kilian-salome/Robot-reveil/README.md

# Robot-reveil
Robot reveil qui s'enfuit
