kilian-salome/Robot-reveil/Rapports seances/Images-import/Read-Me

On crée un fichier avec toutes les images qu'on a besoin d'importer dans nos compte-rendus
