kilian-salome/Robot-reveil/Cahiers_des_charges.md

<h1>Cahiers des charges du projet</h1>
<p>
  <em>Concernant l'idée de ce projet, disons que <a href="https://www.youtube.com/watch?v=izWCU4Y61o4">cette vidéo</a> a été la principale source d'inspiration et que cette idée a réveillée en nous la determination nécessaire à ce projet... </em>
  <h2>Robot-réveil: quésako?</h2>
  <ul>
  <li>Ce projet consiste à créer un robot réveil qui s'enfuit lorsqu'il sonne. Il faut ainsi se lever pour l'arrêter. Le robot peut tomber des meubles. Il peut aussi se prendre des murs. Lorsqu'il s'en prend, il recule un peu puis tourne pour changer de direction.
  
 <li>Le réveil sera programmable depuis un téléphone portable. Il aura donc plusieurs fonctionnalités : alarme et connexion bluetooth. Il pourra aussi donner l'heure lorsqu'on appuie sur un bouton. Sinon, il se mettra en veille.
  
  <li>La voiture pourra tourner, avancer, reculer. Elle sera constituée de deux roues. Il faudra donc mettre un contre-poids pour qu'elle ne tourne pas, que ce soit uniquement les roues qui tournent. 
 
</ul>
<h2>Etapes à suivre:</h2>
<ul>
  <li>Premièrement, il faut faire le réveil. D'abord, réussir à afficher l'heure avec arduino, puis utiliser le module bluetooth pour afficher l'heure depuis notre téléphone portable. Il faut aussi utiliser un buzzer pour pouvoir le faire sonner et s'arrêter lorqu'on appuie.
  <li>Ensuite, il faut faire la voiture. Concernant la structure, on peut soit la dessiner sur un logiciel puis l'imprimer en 3D, soit la constuire nous-même. Pour la faire fonctionner, nous allons utiliser des petits moteurs (comme en TD). Pour relier les roues au moteur, il nous faut des suspensions. 
  <li>Finalement, il faut assembler réveil avec la voiture. Nous allons programmer la voiture de sorte à ce qu'elle se mette en marche lorsque le réveil sonne. Le trajet de la voiture est aléatoire. La voiture s'arrête en même tant que l'alarme.
</ul>
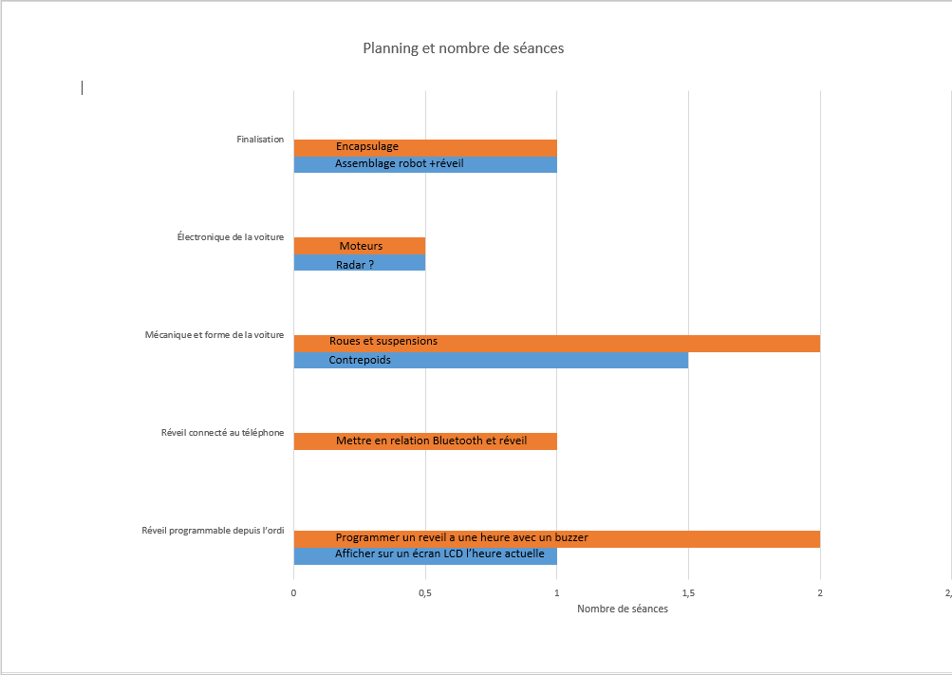
[picture p31: planning n1.png]
voir planning

<em>(Ceci est le planning numéro 1, celui-ci va surement devoir etre bousculé donc on rajoutera les planning au fur et à mesures des séances)</em>

<h2>Problèmes potentiels:</h2>
  <ul> 
  <li>Avec le réveil, on peut avoir des problèmes concernant le module nous permettant d'avoir l'heure. En effet, il n'aura peut être pas assez de pile pour rester allumé toute la nuit. 
  <li>On peut aussi rencontrer des problèmes avec la voiture. D'abord, il ne faut pas qu'elle soit trop fragile puisqu'elle peut tomber des meubles. Ensuite, il faut réussir à trouver un bon moyen de faire un contre poids pour que le système reste toujours dans le même sens.
</ul>
</p>
