kilian-salome/Robot-reveil/planning final.png

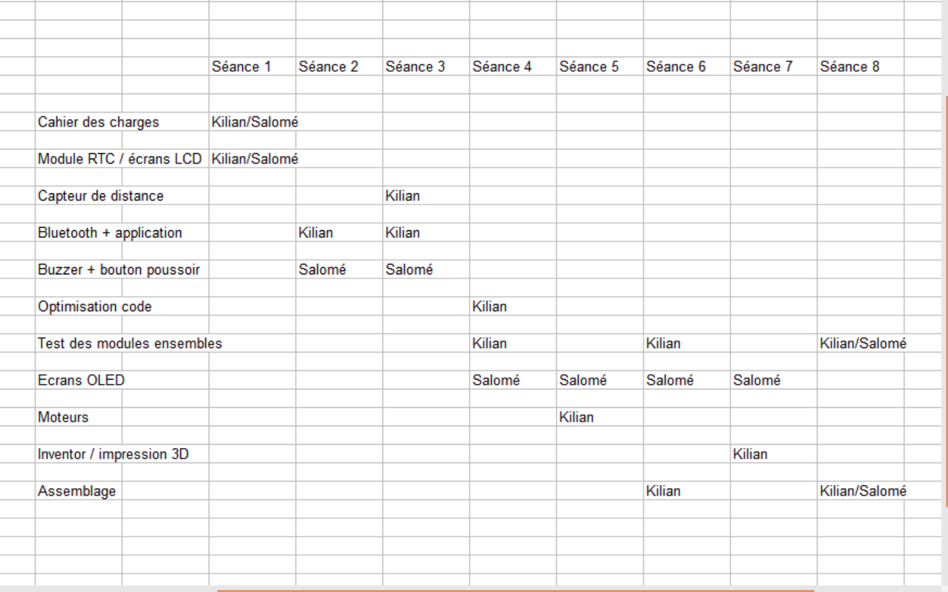
planning final.png
