kilian-salome/Robot-reveil/planning initial.png

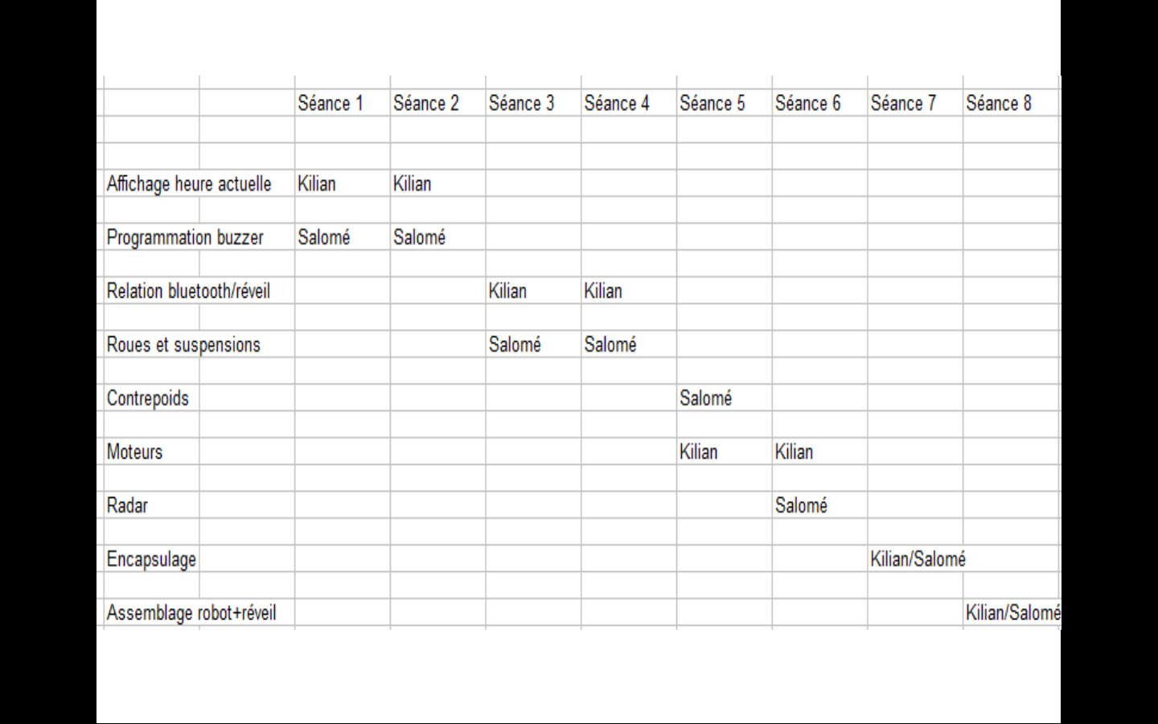
planning initial.png
