kilian-salome/Robot-reveil/Rapports seances/Images-import/presentation projet.jpg

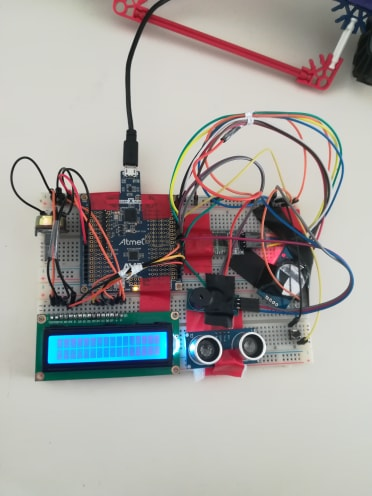
Rapports seances/Images-import/presentation projet.jpg
