kilian-salome/Robot-reveil/Rapport +codes plus diagrammes finals/ecran_couleur.ino

#include <SPI.h>
#include <Wire.h>
#include <Adafruit_GFX.h>
#include <Adafruit_SSD1351.h>

#define OLED_DC    8
#define OLED_CS1  10
#define OLED_CS2  7
#define OLED_RESET1 9
#define OLED_RESET2 6

Adafruit_SSD1351 display1 = Adafruit_SSD1351(OLED_CS1, OLED_DC, OLED_RESET1);
Adafruit_SSD1351 display2 = Adafruit_SSD1351(OLED_CS2, OLED_DC, OLED_RESET2);

// Color definitions
#define  BLACK           0x0000
#define BLUE            0x001F
#define RED             0xF800
#define GREEN           0x07E0
#define CYAN            0x07FF
#define MAGENTA         0xF81F
#define YELLOW          0xFFE0  
#define WHITE           0xFFFF


const unsigned char myBitmap [] PROGMEM = {
  // 'vecteur-de-pixel-de-bit-de-l-ic-ne-d-oeil-eps-91406828, 128x128px
  0xff, 0xff, 0xff, 0xff, 0xff, 0xff, 0xff, 0xff, 0xff, 0xff, 0xff, 0xff, 0xff, 0xff, 0xff, 0xff, 
  0xff, 0xff, 0xff, 0xff, 0xff, 0xff, 0xff, 0xff, 0xff, 0xff, 0xff, 0xff, 0xff, 0xff, 0xff, 0xff, 
  0xff, 0xff, 0xff, 0xff, 0xff, 0xff, 0xff, 0xff, 0xff, 0xff, 0xff, 0xff, 0xff, 0xff, 0xff, 0xff, 
  0xff, 0xff, 0xff, 0xff, 0xff, 0xff, 0xff, 0xff, 0xff, 0xff, 0xff, 0xff, 0xff, 0xff, 0xff, 0xff, 
  0xff, 0xff, 0xff, 0xff, 0xff, 0xff, 0xff, 0xff, 0xff, 0xff, 0xff, 0xff, 0xff, 0xff, 0xff, 0xff, 
  0xff, 0xff, 0xff, 0xff, 0xff, 0xff, 0xff, 0xff, 0xff, 0xff, 0xff, 0xff, 0xff, 0xff, 0xff, 0xff, 
  0xff, 0xff, 0xff, 0xff, 0xff, 0xff, 0xff, 0xff, 0xff, 0xff, 0xff, 0xff, 0xff, 0xff, 0xff, 0xff, 
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
 ;}

void afficherHeure(int a, int b){

  display1.setTextSize(6);
  display1.setTextColor(RED);
  display1.setCursor(20,35);
  display1.print(a);
  display1.print("h"); 
  

  
  display2.setTextSize(6);
  display2.setTextColor(RED);
  display2.setCursor(20,35);
  display2.print(b);
  



}
  
